cpspacesystems/nile-amp/nile_amp.kicad_pcb

## KiCad design nile_amp.kicad_pcb (2026-10-02)

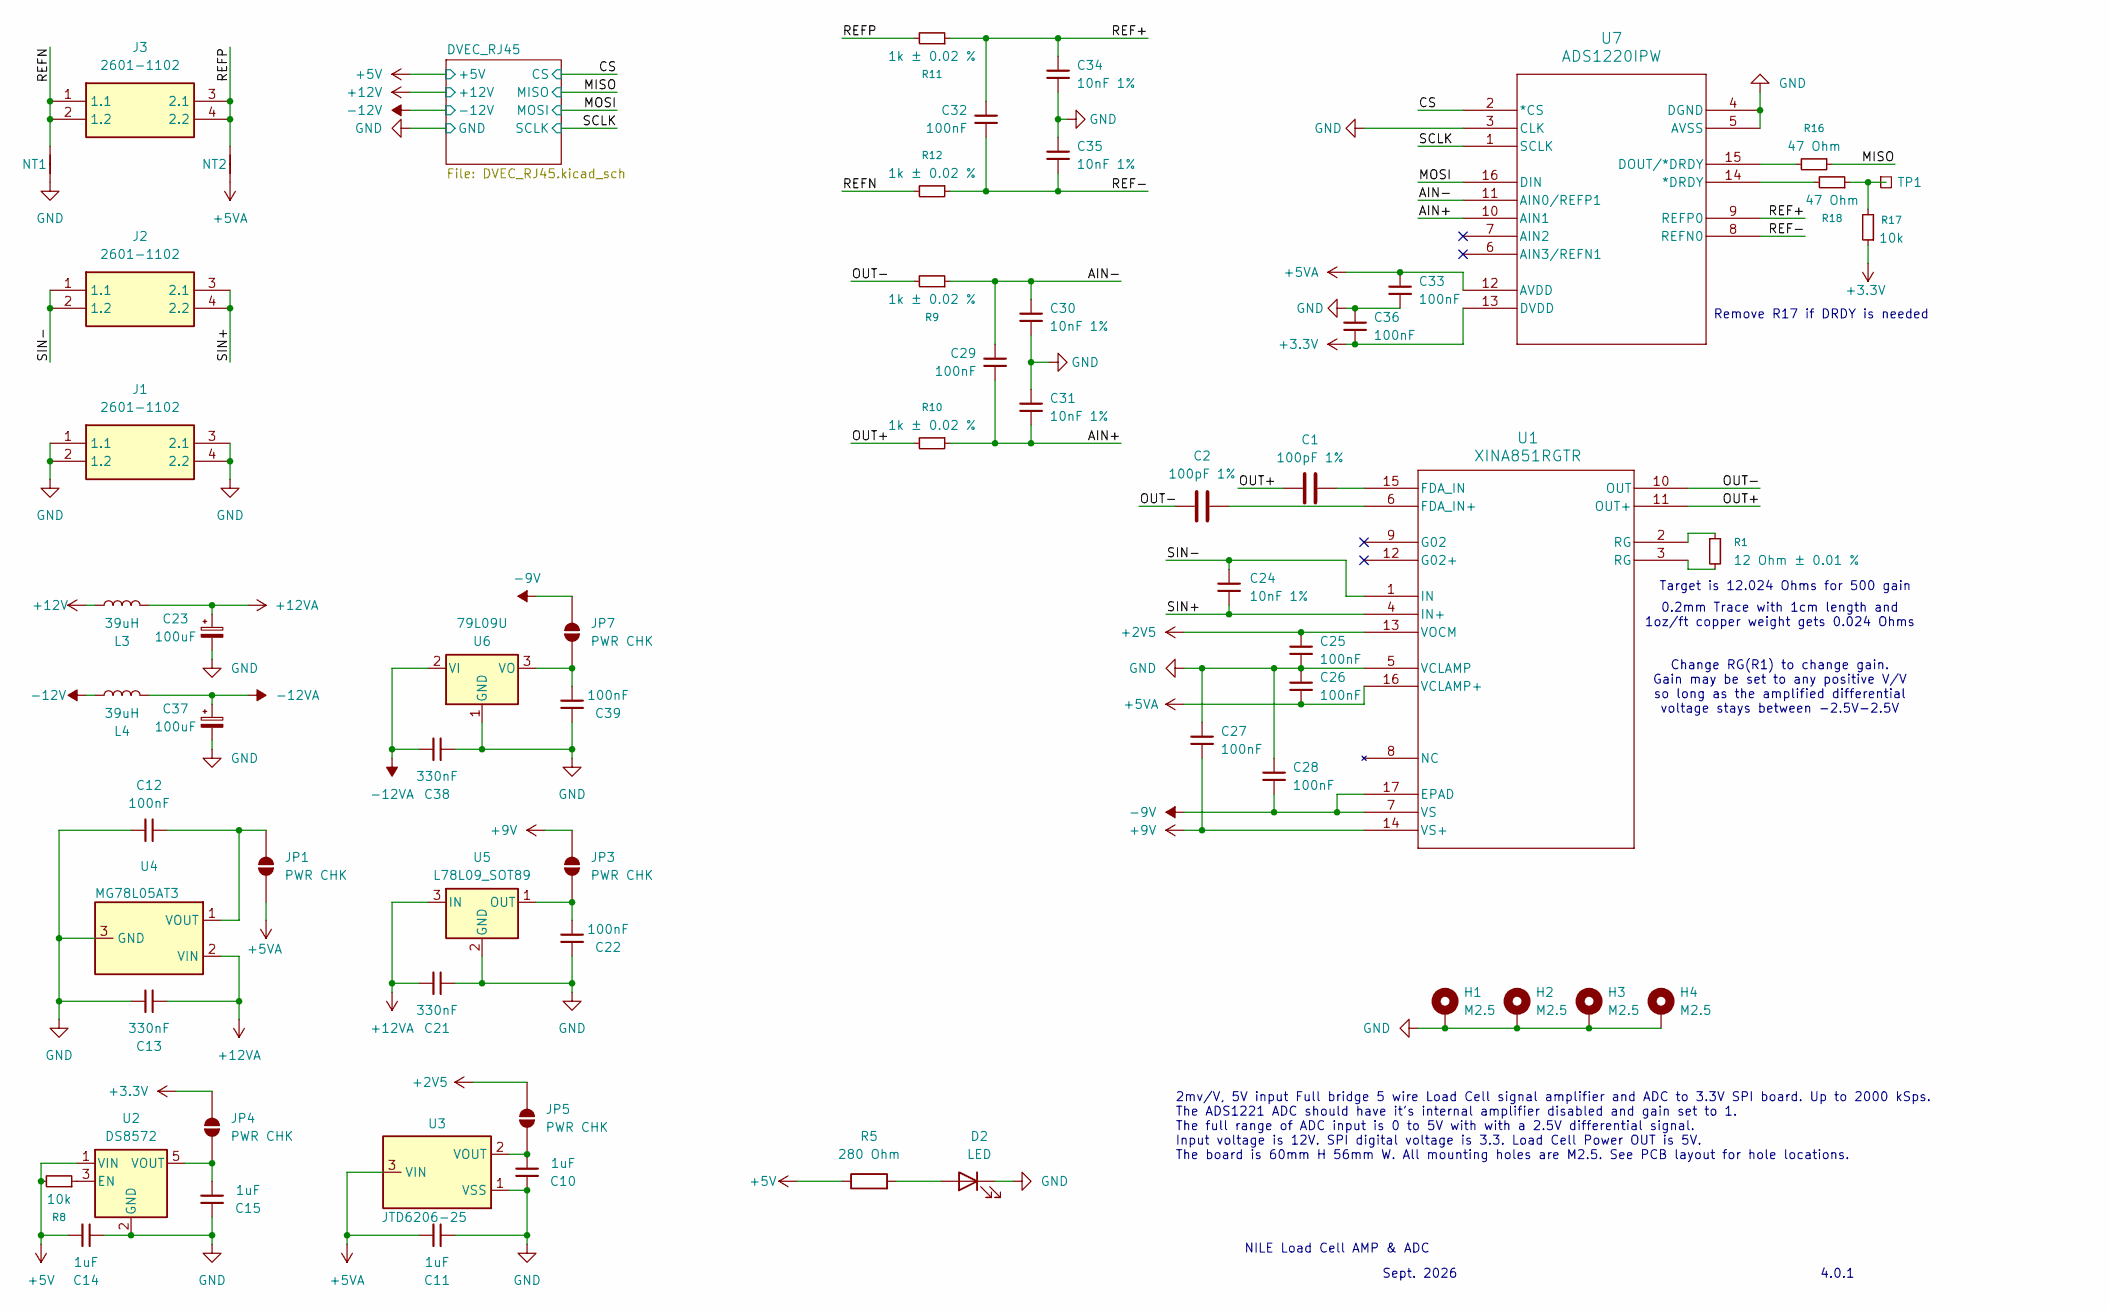
[picture p1: schematic nile_amp.kicad_sch]

Parts:
C1, C2: 100pF 1%; C_0201_0603Metric
C10, C11, C14, C15: 1uF; C_0402_1005Metric
C12, C22, C25, C26, C27, C28, C29, C32, C33, C36, C39: 100nF; C_0402_1005Metric
C13, C21, C38: 330nF; C_0603_1608Metric
C23, C37: 100uF; CP_Radial_D5.0mm_P2.00mm
C24, C30, C31, C34, C35: 10nF 1%; C_0603_1608Metric
D2: LED; LED_0603_1608Metric_Pad1.05x0.95mm_HandSolder
H1, H2, H3, H4: M2.5; MountingHole_2.5mm_Pad_TopBottom
J1, J2, J3: 2601-1102; 26011102; Manufacturer_Part_Number 2601-1102
JP1, JP3, JP4, JP5, JP7: PWR CHK; C_0201_0603Metric
L3, L4: 39uH; CMLF0504-390KTT
NT1, NT2: NetTie_2; NetTie-2_SMD_Pad0.5mm
R1: 12 Ohm ± 0.01 %; R_0805_2012Metric
R5: 280 Ohm; R_0402_1005Metric_Pad0.72x0.64mm_HandSolder
R8, R17: 10k; R_0402_1005Metric_Pad0.72x0.64mm_HandSolder
R9, R10, R11, R12: 1k ± 0.02 %; R_0603_1608Metric
R16, R18: 47 Ohm; R_0402_1005Metric_Pad0.72x0.64mm_HandSolder
TP1: TestPoint_Square; TestPoint_Pad_2.5x2.5mm
U1: XINA851RGTR; VQFN16_RGT_TEX
U2: DS8572; SOT-23-5
U3: JTD6206-25; SOT-23
U4: MG78L05AT3; SOT-23-3
U5: L78L09_SOT89; SOT-89-3
U6: 79L09U; SOT-89-3
U7: ADS1220IPW; PW16

Connections:
+2V5: C25.1, JP5.1 (A), U1.13 (VOCM)
+3.3V: C36.2, JP4.1 (A), R17.1, U7.13 (DVDD)
+5V: C14.1, R5.1, R8.2, U2.1 (VIN); also elsewhere on the board
+5VA: C11.1, C26.2, C33.1, JP1.2 (B), NT2.1, U1.16 (VCLAMP+), U3.3 (VIN), U7.12 (AVDD)
+9V: C27.2, JP3.1 (A), U1.14 (VS+)
+12V: L3.2; also elsewhere on the board
+12VA: C13.2, C21.2, C23.1, L3.1, U4.2 (VIN), U5.3 (IN)
-9V: C28.2, JP7.1 (A), U1.7 (VS), U1.17 (EPAD)
-12V: L4.2; also elsewhere on the board
-12VA: C37.1, C38.2, L4.1, U6.2 (VI)
/AIN+: C29.2, C31.2, R10.1, U7.10 (AIN1)
/AIN-: C29.1, C30.1, R9.1, U7.11 (AIN0/REFP1)
/CS: U7.2 (*CS); also elsewhere on the board
/MISO: R16.1; also elsewhere on the board
/MOSI: U7.16 (DIN); also elsewhere on the board
/OUT+: C1.1, R10.2, U1.11 (OUT+)
/OUT-: C2.1, R9.2, U1.10 (OUT)
/REF+: C32.1, C34.1, R11.1, U7.9 (REFP0)
/REF-: C32.2, C35.2, R12.1, U7.8 (REFN0)
/REFN: J3.1 (1.1), J3.2 (1.2), NT1.2, R12.2
/REFP: J3.3 (2.1), J3.4 (2.2), NT2.2, R11.2
/SCLK: U7.1 (SCLK); also elsewhere on the board
/SIN+: C24.2, J2.3 (2.1), J2.4 (2.2), U1.4 (IN+)
/SIN-: C24.1, J2.1 (1.1), J2.2 (1.2), U1.1 (IN)
GND: C10.1, C11.2, C12.2, C13.1, C14.2, C15.1, C21.1, C22.1, C23.2, C25.2, C26.1, C27.1, C28.1, C30.2, C31.1, C33.2, C34.2, C35.1, C36.1, C37.2, C38.1, C39.1, D2.1 (K), H1.1 (1_1), H2.1 (1_1), H3.1 (1_1), H4.1 (1_1), J1.1 (1.1), J1.2 (1.2), J1.3 (2.1), J1.4 (2.2), NT1.1, U1.5 (VCLAMP), U2.2 (GND), U3.1 (VSS), U4.3 (GND), U5.2 (GND), U6.1 (GND), U7.3 (CLK), U7.4 (DGND), U7.5 (AVSS); also elsewhere on the board
unnamed: D2.2 (A), R5.2
unnamed: C12.1, JP1.1 (A), U4.1 (VOUT)
unnamed: C22.2, JP3.2 (B), U5.1 (OUT)
unnamed: C15.2, JP4.2 (B), U2.5 (VOUT)
unnamed: C10.2, JP5.2 (B), U3.2 (VOUT)
unnamed: C39.2, JP7.2 (B), U6.3 (VO)
unnamed: R1.1, U1.2 (RG)
unnamed: R1.2, U1.3 (RG)
unnamed: R17.2, R18.1, TP1.1 (1_1)
unnamed: C1.2, U1.15 (FDA_IN)
unnamed: C2.2, U1.6 (FDA_IN+)
unnamed: R8.1, U2.3 (EN)
unnamed: R18.2, U7.14 (*DRDY)
unnamed: R16.2, U7.15 (DOUT/*DRDY)

Notes on the sheet:
4.0.1
Remove R17 if DRDY is needed
NILE Load Cell AMP & ADC
Target is 12.024 Ohms for 500 gain
2mv/V, 5V input Full bridge 5 wire Load Cell signal amplifier and ADC to 3.3V SPI board. Up to 2000 kSps. The ADS1221 ADC should have it's internal amplifier disabled and gain set to 1. The full range of ADC input is 0 to 5V with with a 2.5V differential signal. Input voltage is 12V. SPI digital vo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
Change RG(R1) to change gain. Gain may be set to any positive V/V so long as the amplified differential voltage stays between -2.5V-2.5V
0.2mm Trace with 1cm length and 1oz/ft copper weight gets 0.024 Ohms
Sept. 2026

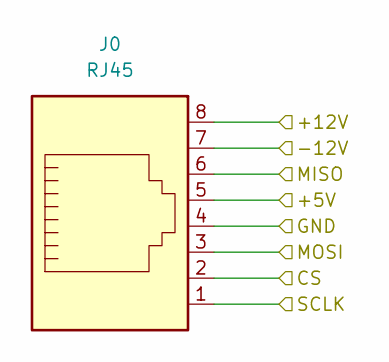
[picture p2: schematic DVEC_RJ45.kicad_sch]

Parts:
J0: RJ45; RJ45-TH_RJ-804-1-6 Yellow

Connections:
+5V: J0.5; also elsewhere on the board
+12V: J0.8; also elsewhere on the board
-12V: J0.7; also elsewhere on the board
/CS: J0.2; also elsewhere on the board
/MISO: J0.6; also elsewhere on the board
/MOSI: J0.3; also elsewhere on the board
/SCLK: J0.1; also elsewhere on the board
GND: J0.4; also elsewhere on the board

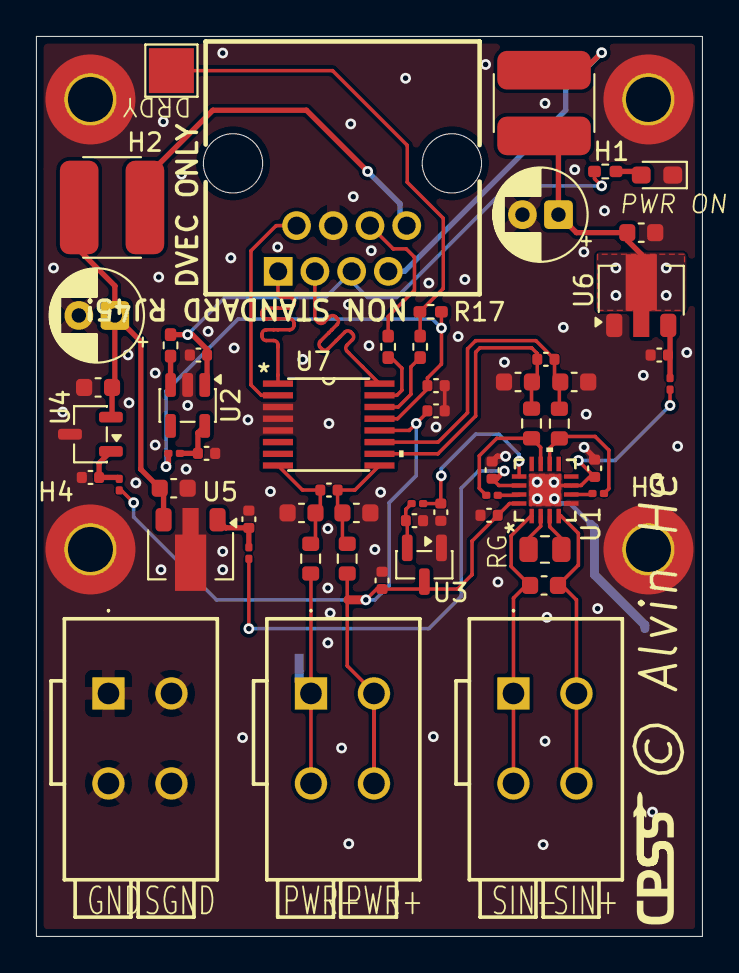
[picture p3: board nile_amp.kicad_pcb from above]

Board: 2 copper layers, 37.0 x 50.0 mm, 63 parts (1 on the bottom side), 39 nets.
