cpspacesystems/nile-amp/(commit log)

2026-09-03 Base Implenmentation of AMP&ADC
    [nile_amp.kicad_pcb, nile_amp.kicad_sch]
2026-09-05 Rev 1 Done
    [nile_amp.kicad_pcb, nile_amp.kicad_sch]
2026-09-06 Changed over from test pad to solder jumpers for voltage verification
    [nile_amp.kicad_pcb, nile_amp.kicad_sch]
2026-09-07 changed 3.3V regulator to match rpi breakout board, also redid power supply
    [nile_amp.kicad_pcb, nile_amp.kicad_sch]
2026-09-07 REV 2: Switched to using REF1 pair on ADS1220 and also moved SPI ports so they are on the 12V side
    [nile_amp.kicad_pcb, nile_amp.kicad_sch]
2026-09-10 R3: Changed over to using PSU -12V instead of on board switching supply, added proper SPI chaining support
    [nile_amp.kicad_pcb, nile_amp.kicad_sch]
2026-10-02 Use DVEC, finalized layout & dimensions
    [DVEC_RJ45.kicad_sch, nile_amp.csv, nile_amp.kicad_pcb, nile_amp.kicad_sch]
