cpspacesystems/nile-amp/(notices)

Notices in the files:
nile_amp.kicad_pcb:
© Alvin He
